parkourlrc/pcb-ben5049--cm-carrier-hardware-8420f170ef/pcbs/cm5-carrier-v2/cm5.kicad_sch

## KiCad design pcbs/cm5-carrier-v2/cm5.kicad_sch (2026-09-21)

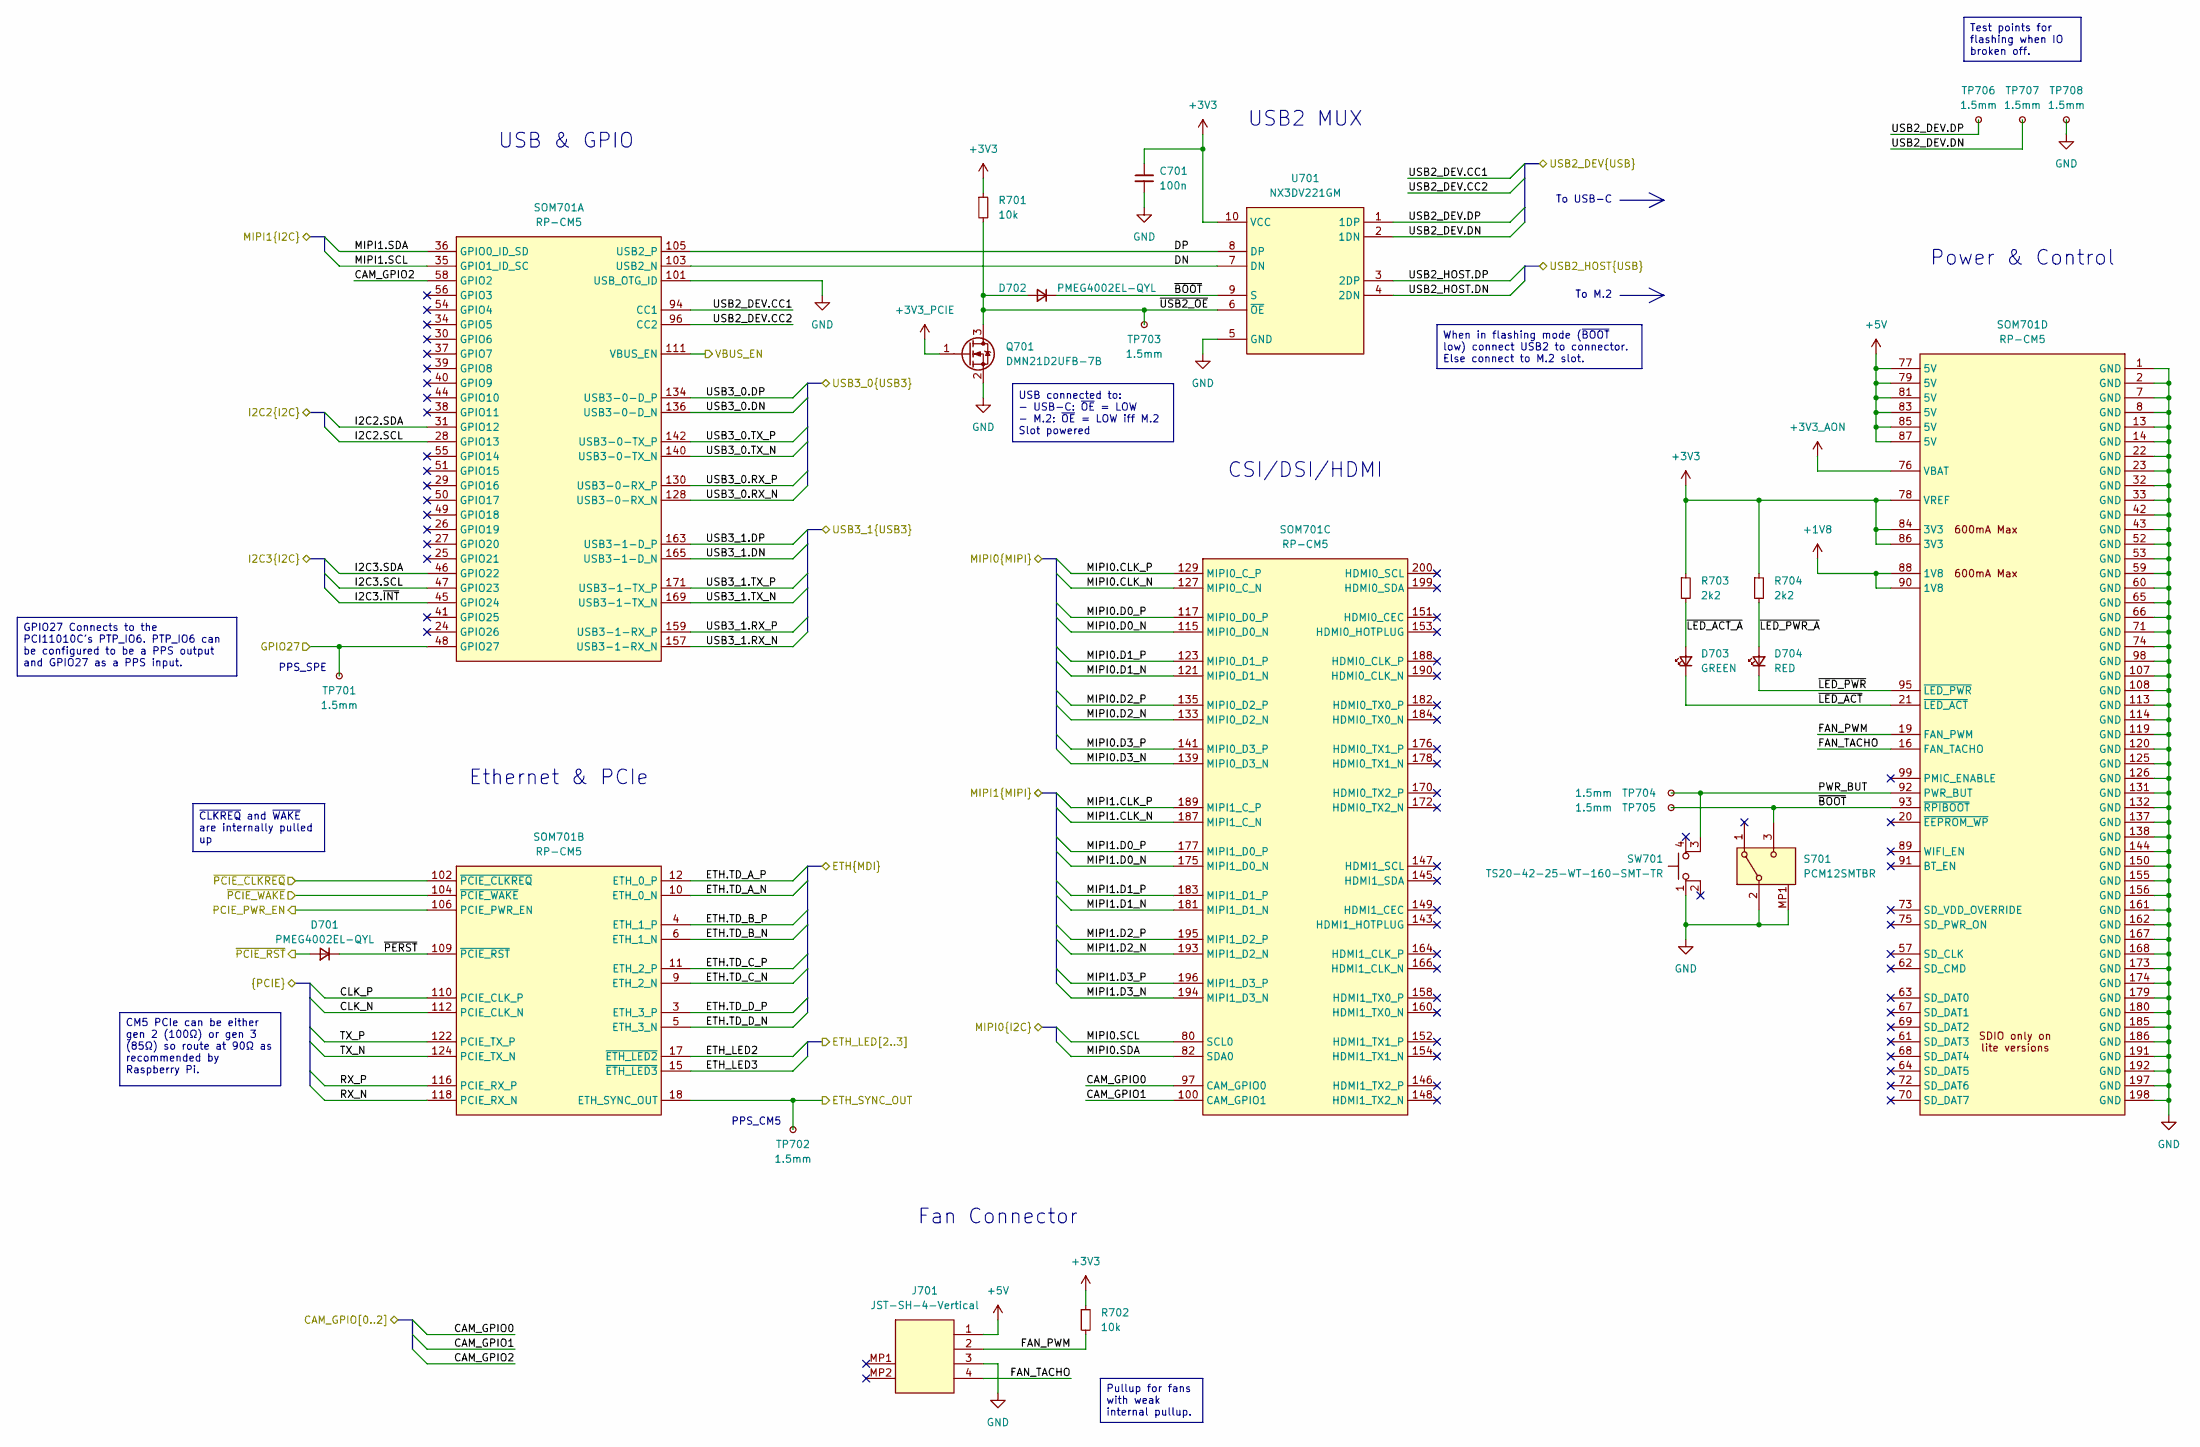
[picture p1: schematic cm5.kicad_sch]

Parts:
C701: 100n; C_0402
D701, D702: PMEG4002EL-QYL
D703: GREEN; LED_0402
D704: RED; LED_0402
J701: JST-SH-4-Vertical; JST_SH_BM04B-SRSS-TB_1x04-1MP_P1.00mm_Vertical
Q701: DMN21D2UFB-7B; DMN21D2UFB7B; Mouser Part Number 621-DMN21D2UFB-7B
R701, R702: 10k; R_0402
R703, R704: 2k2; R_0402
S701: PCM12SMTBR
SOM701: RP-CM5; Raspberry-Pi-5-Compute-Module
SW701: TS20-42-25-WT-160-SMT-TR; TS204225WT160SMTTR; Mouser Part Number 179-TS204225WT160SMT
TP701, TP702, TP703, TP704, TP705, TP706, TP707, TP708: 1.5mm; TestPoint_Pad_D1.5mm
U701: NX3DV221GM; NX3DV221GM115

Connections:
+1V8: SOM701.88 (1V8), SOM701.90 (1V8)
+3V3: C701.1, R701.1, R702.1, R703.1, R704.1, SOM701.78 (VREF), SOM701.84 (3V3), SOM701.86 (3V3), U701.10 (VCC)
+3V3_AON: SOM701.76 (VBAT)
+3V3_PCIE: Q701.1 (G)
+5V: J701.1, SOM701.77 (5V), SOM701.79 (5V), SOM701.81 (5V), SOM701.83 (5V), SOM701.85 (5V), SOM701.87 (5V)
CAM_GPIO0: SOM701.97 (CAM_GPIO0)
CAM_GPIO1: SOM701.100 (CAM_GPIO1)
CAM_GPIO2: SOM701.58 (GPIO2)
CLK_N: SOM701.112 (PCIE_CLK_N)
CLK_P: SOM701.110 (PCIE_CLK_P)
DN: SOM701.103 (USB2_N), U701.7 (DN)
DP: SOM701.105 (USB2_P), U701.8 (DP)
ETH.TD_A_N: SOM701.10 (ETH_0_N)
ETH.TD_A_P: SOM701.12 (ETH_0_P)
ETH.TD_B_N: SOM701.6 (ETH_1_N)
ETH.TD_B_P: SOM701.4 (ETH_1_P)
ETH.TD_C_N: SOM701.9 (ETH_2_N)
ETH.TD_C_P: SOM701.11 (ETH_2_P)
ETH.TD_D_N: SOM701.5 (ETH_3_N)
ETH.TD_D_P: SOM701.3 (ETH_3_P)
ETH_LED2: SOM701.17 (~ETH_LED2)
ETH_LED3: SOM701.15 (~ETH_LED3)
ETH_SYNC_OUT: SOM701.18 (ETH_SYNC_OUT), TP702.1
FAN_PWM: J701.2, R702.2, SOM701.19 (FAN_PWM)
FAN_TACHO: J701.4, SOM701.16 (FAN_TACHO)
GND: C701.2, J701.3, Q701.2 (S), S701.2 (COM), S701.MP1, S701.MP2, S701.MP3, S701.MP4, SOM701.1 (GND), SOM701.2 (GND), SOM701.7 (GND), SOM701.8 (GND), SOM701.13 (GND), SOM701.14 (GND), SOM701.22 (GND), SOM701.23 (GND), SOM701.32 (GND), SOM701.33 (GND), SOM701.42 (GND), SOM701.43 (GND), SOM701.52 (GND), SOM701.53 (GND), SOM701.59 (GND), SOM701.60 (GND), SOM701.65 (GND), SOM701.66 (GND), SOM701.71 (GND), SOM701.74 (GND), SOM701.98 (GND), SOM701.101 (USB_OTG_ID), SOM701.107 (GND), SOM701.108 (GND), SOM701.113 (GND), SOM701.114 (GND), SOM701.119 (GND), SOM701.120 (GND), SOM701.125 (GND), SOM701.126 (GND), SOM701.131 (GND), SOM701.132 (GND), SOM701.137 (GND), SOM701.138 (GND), SOM701.144 (GND), SOM701.150 (GND), SOM701.155 (GND), SOM701.156 (GND), SOM701.161 (GND), SOM701.162 (GND), SOM701.167 (GND), SOM701.168 (GND), SOM701.173 (GND), SOM701.174 (GND), SOM701.179 (GND), SOM701.180 (GND), SOM701.185 (GND), SOM701.186 (GND), SOM701.191 (GND), SOM701.192 (GND), SOM701.197 (GND), SOM701.198 (GND), SW701.1, TP708.1, U701.5 (GND)
GPIO27: SOM701.48 (GPIO27), TP701.1
I2C2.SCL: SOM701.28 (GPIO13)
I2C2.SDA: SOM701.31 (GPIO12)
I2C3.SCL: SOM701.47 (GPIO23)
I2C3.SDA: SOM701.46 (GPIO22)
I2C3.~INT: SOM701.45 (GPIO24)
MIPI0.CLK_N: SOM701.127 (MIPI0_C_N)
MIPI0.CLK_P: SOM701.129 (MIPI0_C_P)
MIPI0.D0_N: SOM701.115 (MIPI0_D0_N)
MIPI0.D0_P: SOM701.117 (MIPI0_D0_P)
MIPI0.D1_N: SOM701.121 (MIPI0_D1_N)
MIPI0.D1_P: SOM701.123 (MIPI0_D1_P)
MIPI0.D2_N: SOM701.133 (MIPI0_D2_N)
MIPI0.D2_P: SOM701.135 (MIPI0_D2_P)
MIPI0.D3_N: SOM701.139 (MIPI0_D3_N)
MIPI0.D3_P: SOM701.141 (MIPI0_D3_P)
MIPI0.SCL: SOM701.80 (SCL0)
MIPI0.SDA: SOM701.82 (SDA0)
MIPI1.CLK_N: SOM701.187 (MIPI1_C_N)
MIPI1.CLK_P: SOM701.189 (MIPI1_C_P)
MIPI1.D0_N: SOM701.175 (MIPI1_D0_N)
MIPI1.D0_P: SOM701.177 (MIPI1_D0_P)
MIPI1.D1_N: SOM701.181 (MIPI1_D1_N)
MIPI1.D1_P: SOM701.183 (MIPI1_D1_P)
MIPI1.D2_N: SOM701.193 (MIPI1_D2_N)
MIPI1.D2_P: SOM701.195 (MIPI1_D2_P)
MIPI1.D3_N: SOM701.194 (MIPI1_D3_N)
MIPI1.D3_P: SOM701.196 (MIPI1_D3_P)
MIPI1.SCL: SOM701.35 (GPIO1_ID_SC)
MIPI1.SDA: SOM701.36 (GPIO0_ID_SD)
PCIE_PWR_EN: SOM701.106 (PCIE_PWR_EN)
PWR_BUT: SOM701.92 (PWR_BUT), SW701.3, TP704.1
RX_N: SOM701.118 (PCIE_RX_N)
RX_P: SOM701.116 (PCIE_RX_P)
TX_N: SOM701.124 (PCIE_TX_N)
TX_P: SOM701.122 (PCIE_TX_P)
USB2_DEV.CC1: SOM701.94 (CC1)
USB2_DEV.CC2: SOM701.96 (CC2)
USB2_DEV.DN: TP707.1, U701.2 (1DN)
USB2_DEV.DP: TP706.1, U701.1 (1DP)
USB2_HOST.DN: U701.4 (2DN)
USB2_HOST.DP: U701.3 (2DP)
USB3_0.DN: SOM701.136 (USB3-0-D_N)
USB3_0.DP: SOM701.134 (USB3-0-D_P)
USB3_0.RX_N: SOM701.128 (USB3-0-RX_N)
USB3_0.RX_P: SOM701.130 (USB3-0-RX_P)
USB3_0.TX_N: SOM701.140 (USB3-0-TX_N)
USB3_0.TX_P: SOM701.142 (USB3-0-TX_P)
USB3_1.DN: SOM701.165 (USB3-1-D_N)
USB3_1.DP: SOM701.163 (USB3-1-D_P)
USB3_1.RX_N: SOM701.157 (USB3-1-RX_N)
USB3_1.RX_P: SOM701.159 (USB3-1-RX_P)
USB3_1.TX_N: SOM701.169 (USB3-1-TX_N)
USB3_1.TX_P: SOM701.171 (USB3-1-TX_P)
VBUS_EN: SOM701.111 (VBUS_EN)
~BOOT: D702.1 (K), S701.3 (NO), SOM701.93 (~RPIBOOT), TP705.1, U701.9 (S)
~LED_ACT_A: D703.2 (A), R703.2
~LED_ACT: D703.1 (K), SOM701.21 (~LED_ACT)
~LED_PWR_A: D704.2 (A), R704.2
~LED_PWR: D704.1 (K), SOM701.95 (~LED_PWR)
~PCIE_CLKREQ: SOM701.102 (~PCIE_CLKREQ)
~PCIE_RST: D701.2 (A)
~PCIE_WAKE: SOM701.104 (~PCIE_WAKE)
~PERST: D701.1 (K), SOM701.109 (~PCIE_RST)
~USB2_OE: D702.2 (A), Q701.3 (D), R701.2, TP703.1, U701.6 (~OE)

Notes on the sheet:
Ethernet & PCIe
USB & GPIO
To USB-C
PPS_CM5
Fan Connector
USB2 MUX
PPS_SPE
Power & Control
To M.2
CSI/DSI/HDMI
When in flashing mode (~{BOOT} low) connect USB2 to connector. Else connect to M.2 slot.
GPIO27 Connects to the PCI11010C's PTP_IO6. PTP_IO6 can be configured to be a PPS output and GPIO27 as a PPS input.
USB connected to: - USB-C: ~{OE} = LOW - M.2: ~{OE} = LOW iff M.2 Slot powered
~{CLKREQ} and ~{WAKE} are internally pulled up
CM5 PCIe can be either gen 2 (100Ω) or gen 3 (85Ω) so route at 90Ω as recommended by Raspberry Pi.
Pullup for fans with weak internal pullup.
Test points for flashing when IO broken off.
